LTU-CEG/mav_psu/(commit log)

2018-11-03 Updated PCB to use 0603 components
    [drone_psu-B.Paste.gbr, drone_psu-F.Paste.gbr, drone_psu.GBL, drone_psu.GBO, drone_psu.GBS, drone_psu.GKO, drone_psu.GTL, drone_psu.GTO]
2018-11-03 Fixed error in PCB stop mask
    [drone_psu-F.Paste.gbr, drone_psu.GBL, drone_psu.GBO, drone_psu.GBS, drone_psu.GKO, drone_psu.GTL, drone_psu.GTO, drone_psu.GTS]
2018-11-03 Increased distance between passives for easier mounting
    [drone_psu-F.Paste.gbr, drone_psu.GBL, drone_psu.GBO, drone_psu.GBS, drone_psu.GKO, drone_psu.GTL, drone_psu.GTO, drone_psu.GTS]
2018-11-04 Renamed files to follow the project name, minor hint on application added
    [mav_psu.kicad_pcb, mav_psu.sch]
2019-03-24 Updated with castelated vias
    [drone_psu.GBL, drone_psu.GBS, drone_psu.GKO, drone_psu.GTL, drone_psu.GTS, mav_psu-B_Cu.gbr, mav_psu-B_Mask.gbr, mav_psu-B_Paste.gbr]
2019-03-24 Improved design, now smaller and with correct inductor footprint
    [mav_psu-B_Cu.gbr, mav_psu-B_Mask.gbr, mav_psu-B_Paste.gbr, mav_psu-B_SilkS.gbr, mav_psu-Edge_Cuts.gbr, mav_psu-F_Cu.gbr, mav_psu-F_Mask.gbr, mav_psu-F_Paste.gbr]
